Agilack/cowdin-3c-esp-ui/README.md

CowDIN ESP-UI
=============

This project is an electronic module to add a user interface (display +
buttons) as frontend of a DIN enclosure (3U). It can be used for example
with the cowdin ESP32 communication module (see cowdin-3b-esp32)

<table>
<tr>
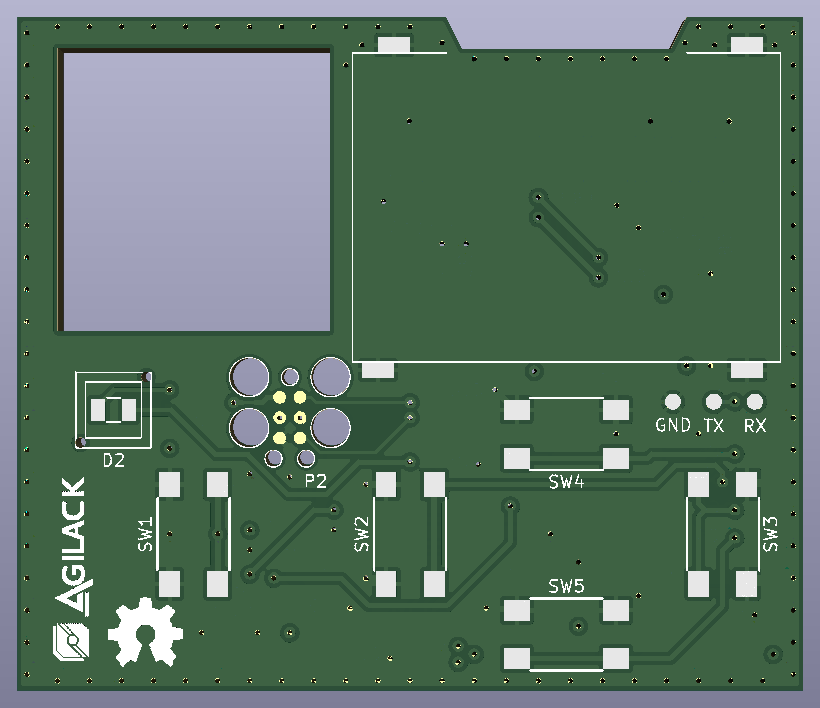
[picture p1: hardware/doc/kicad-3d-top.png]
KiCad 3D (top side)
<td></td>
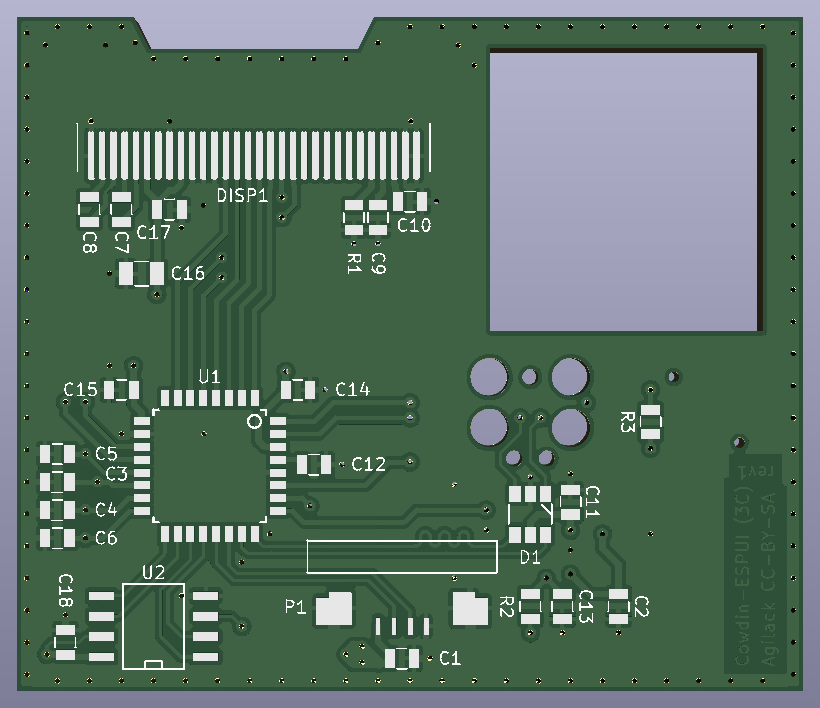
[picture p2: hardware/doc/kicad-3d-bottom.png]
KiCad 3D (bottom side)
<td></td>
</tr><tr>
<td>Fig1: Kicad 3D preview (top)</td>
<td>Fig2: Kicad 3D preview (bottom)</td>
</tr>
</table>

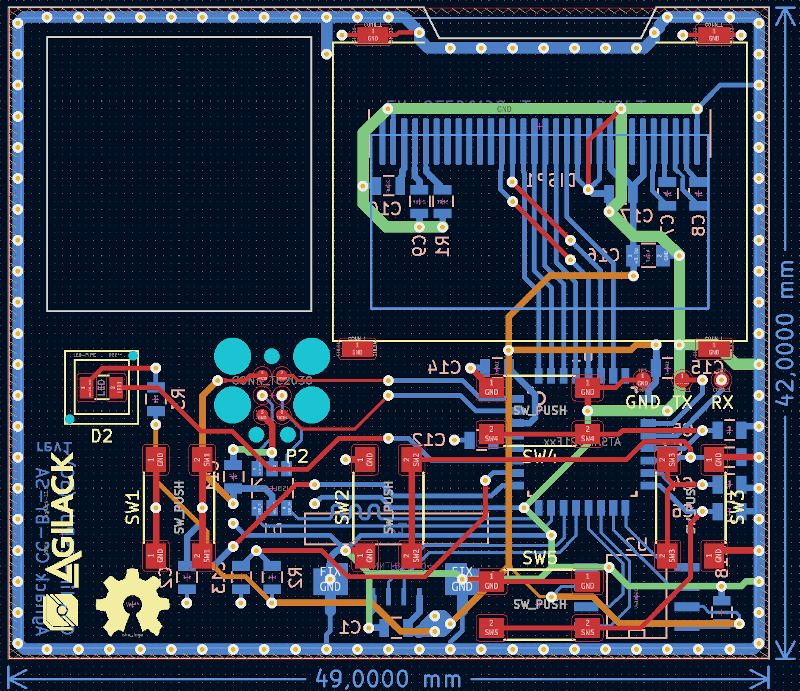
[picture p3: hardware/doc/kicad-routing-preview.png]
Preview of PCB Wip


License
-------

This project is OpenHardware. Hardware design and materials are published
under terms of the Creative Commons ShareAlike license (CC-by-SA) see
hardware/License.md.
