Agilack/cowdin-3c-esp-ui/hardware/prj-kicad/cowdin-3c-esp-ui.kicad_pcb

## KiCad design hardware/prj-kicad/cowdin-3c-esp-ui.kicad_pcb (2022-06-11)

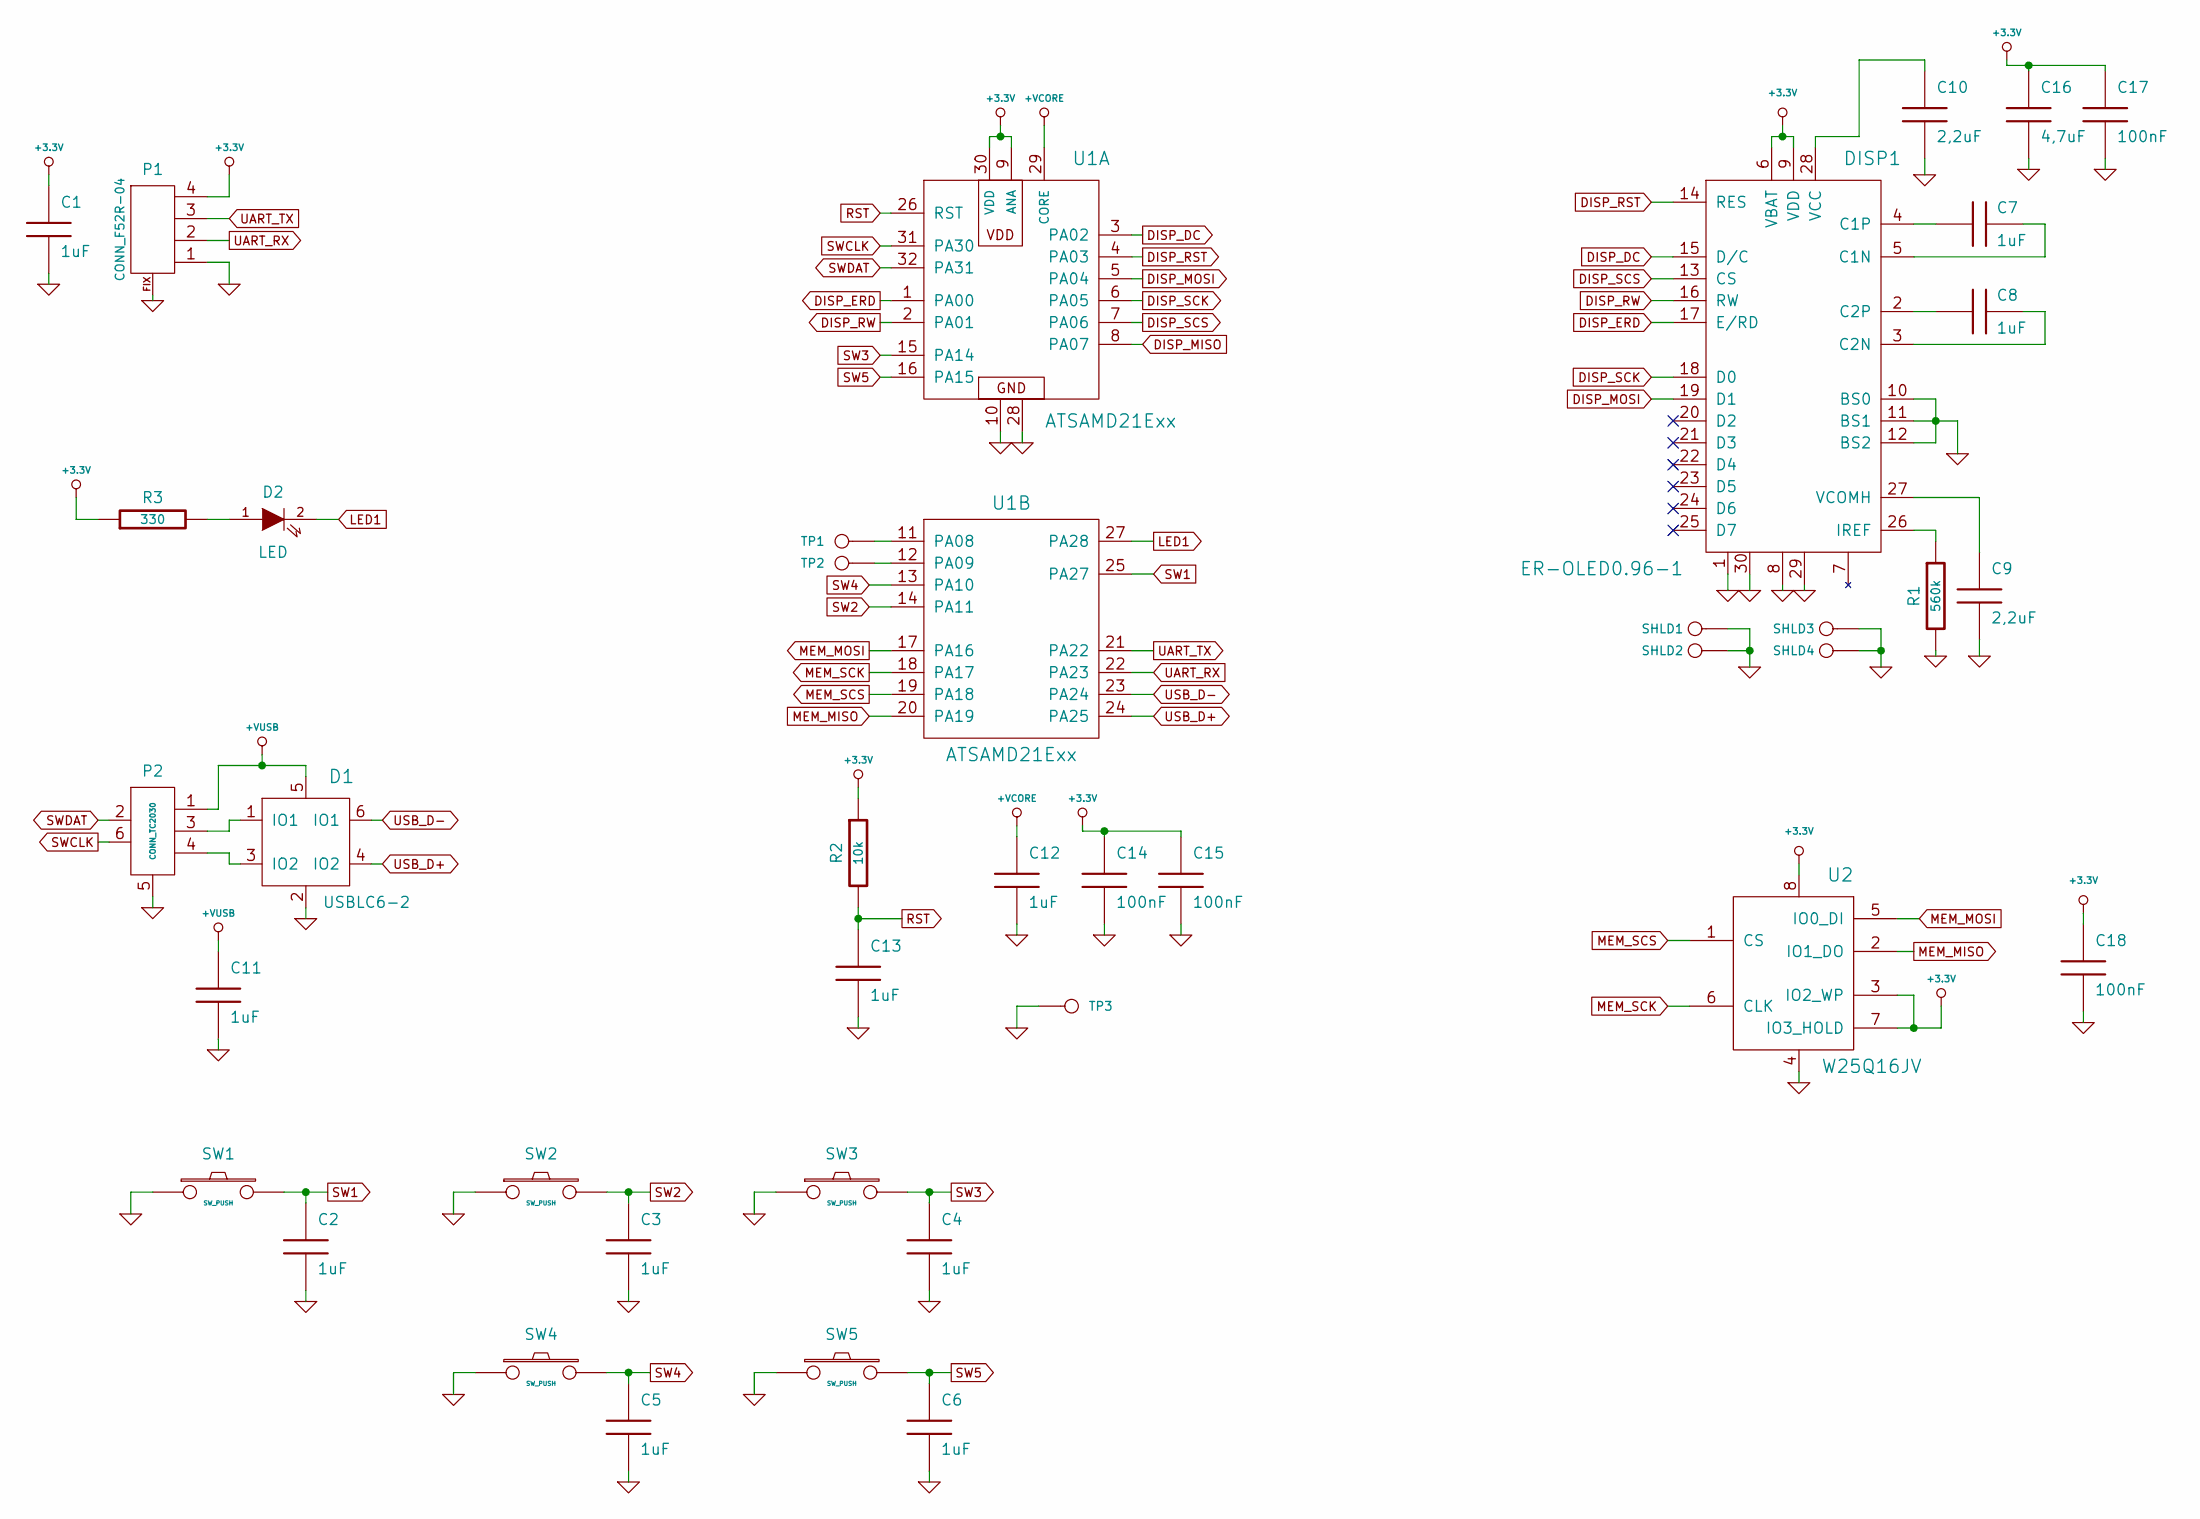
[picture p4: schematic cowdin-3c-esp-ui.kicad_sch, CowDIN button and display module for ESP32 (3B)]

Parts:
C1, C2, C3, C4, C5, C6, C7, C8, C11, C12, C13: 1uF; SMD0603
C9, C10: 2,2uF; SMD0603
C14, C15, C17, C18: 100nF; SMD0603
C16: 4,7uF; SMD0805
D1: USBLC6-2; SOT23-6
D2: LED; SMD0805
DISP1: ER-OLED0.96-1; DISP_EROL30
P1: CONN_F52R-04
P2: CONN_TC2030; TC2030-MCP-FP
R1: 560k; SMD0603
R2: 10k; SMD0603
R3: 330; SMD0603
SHLD1, SHLD2, SHLD3, SHLD4: CONN_1; SHLD_PAD
SW1, SW2, SW3, SW4, SW5: SW_PUSH; SW_TSC015xx
TP1, TP2, TP3: CONN_1; TP_SMD
U1: ATSAMD21Exx; TQFP32
U2: W25Q16JV; SOIC-8

Connections:
+3.3V: C1.1, C14.1, C15.1, C16.1, C17.1, C18.1, DISP1.6 (VBAT), DISP1.9 (VDD), P1.4, R2.1, R3.1, U1.9 (ANA), U1.30 (VDD), U2.3 (IO2_WP), U2.7 (IO3_HOLD), U2.8
+VCORE: C12.1, U1.29 (CORE)
+VUSB: C11.1, D1.5, P2.1 (PWR)
DISP_DC: DISP1.15 (D/C), U1.3 (PA02)
DISP_ERD: DISP1.17 (E/RD), U1.1 (PA00)
DISP_MISO: U1.8 (PA07)
DISP_MOSI: DISP1.19 (D1), U1.5 (PA04)
DISP_RST: DISP1.14 (RES), U1.4 (PA03)
DISP_RW: DISP1.16 (RW), U1.2 (PA01)
DISP_SCK: DISP1.18 (D0), U1.6 (PA05)
DISP_SCS: DISP1.13 (CS), U1.7 (PA06)
LED1: D2.2 (K), U1.27 (PA28)
MEM_MISO: U1.20 (PA19), U2.2 (IO1_DO)
MEM_MOSI: U1.17 (PA16), U2.5 (IO0_DI)
MEM_SCK: U1.18 (PA17), U2.6 (CLK)
MEM_SCS: U1.19 (PA18), U2.1 (CS)
unnamed: C7.1, DISP1.4 (C1P)
unnamed: C7.2, DISP1.5 (C1N)
unnamed: C8.1, DISP1.2 (C2P)
unnamed: C8.2, DISP1.3 (C2N)
unnamed: C9.1, DISP1.27 (VCOMH)
unnamed: C10.1, DISP1.28 (VCC)
unnamed: D1.1 (IO1), P2.3 (USB1)
unnamed: D1.3 (IO2), P2.4 (USB2)
unnamed: D2.1 (A), R3.2
unnamed: DISP1.26 (IREF), R1.1
unnamed: TP1.1, U1.11 (PA08)
unnamed: TP2.1, U1.12 (PA09)
RST: C13.1, R2.2, U1.26 (RST)
SW1: C2.1, SW1.2, U1.25 (PA27)
SW2: C3.1, SW2.2, U1.14 (PA11)
SW3: C4.1, SW3.2, U1.15 (PA14)
SW4: C5.1, SW4.2, U1.13 (PA10)
SW5: C6.1, SW5.2, U1.16 (PA15)
SWCLK: P2.6 (DBG2), U1.31 (PA30)
SWDAT: P2.2 (DBG1), U1.32 (PA31)
UART_RX: P1.2 (PM), U1.22 (PA23)
UART_TX: P1.3, U1.21 (PA22)
USB_D+: D1.4 (IO2), U1.24 (PA25)
USB_D-: D1.6 (IO1), U1.23 (PA24)

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
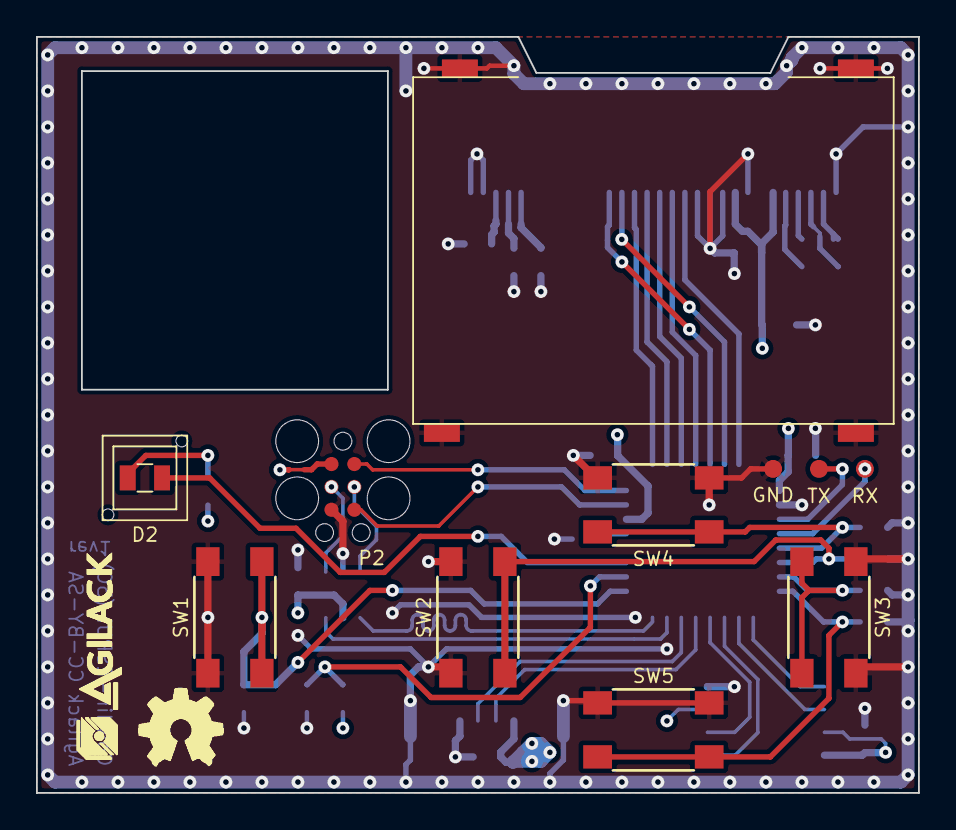
[picture p5: board cowdin-3c-esp-ui.kicad_pcb from above]

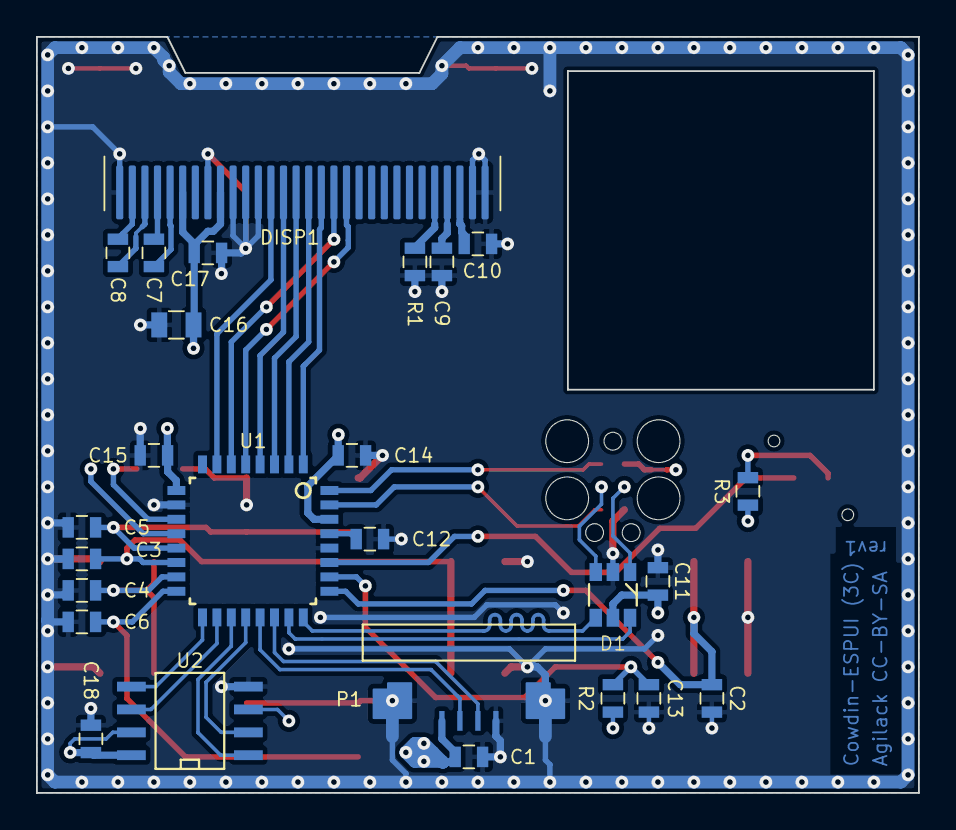
[picture p6: board cowdin-3c-esp-ui.kicad_pcb from below]

Board: 4 copper layers, 49.0 x 42.0 mm, 42 parts (26 on the bottom side), 40 nets.

Other parts of the board:
agilack-11.5: 450px; logo-agilack-11.5
ohw_logo: VAL**; logo-ohw
