Agilack/cowdin-3c-esp-ui/firmware/src/display_font.h

/**
 * @file  display_font.h
 * @brief Bitmap of the default 8x8 text font
 *
 * @author Saint-Genest Gwenael <gwen@cowlab.fr>
 * @copyright Agilack (c) 2022
 *
 * @page License
 * Cowdin-3C-ui firmware is free software: you can redistribute it and/or
 * modify it under the terms of the GNU Lesser General Public License
 * version 3 as published by the Free Software Foundation. You should
 * have received a copy of the GNU Lesser General Public License along
 * with this program, see LICENSE.md file for more details.
 * This program is distributed WITHOUT ANY WARRANTY.
 */
#ifndef FONT_H
#define FONT_H

const unsigned char font[96][8] = {
/* 0x20 */
    { 0x00, 0x00, 0x00, 0x00, 0x00, 0x00, 0x00, 0x00 }, /* space */
    { 0x00, 0x00, 0x00, 0x00, 0x2F, 0x00, 0x00, 0x00 }, /* ! */
    { 0x00, 0x00, 0x03, 0x00, 0x03, 0x00, 0x00, 0x00 }, /* " */
    { 0x00, 0x14, 0x3E, 0x14, 0x3E, 0x14, 0x00, 0x00 }, /* # */
    { 0x00, 0x00, 0x24, 0x2A, 0x7F, 0x2A, 0x12, 0x00 }, /* $ */
    { 0x02, 0x05, 0x15, 0x0A, 0x14, 0x2A, 0x28, 0x10 }, /* % */
    { 0x00, 0x00, 0x16, 0x29, 0x29, 0x11, 0x10, 0x28 }, /* & */
    { 0x00, 0x00, 0x00, 0x00, 0x03, 0x00, 0x00, 0x00 }, /* ' */
    { 0x00, 0x00, 0x0C, 0x12, 0x21, 0x00, 0x00, 0x00 }, /* ( */
    { 0x00, 0x00, 0x00, 0x21, 0x12, 0x0C, 0x00, 0x00 }, /* ) */
    { 0x00, 0x00, 0x15, 0x0E, 0x1F, 0x0E, 0x15, 0x00 }, /* * */
    { 0x00, 0x00, 0x08, 0x08, 0x3E, 0x08, 0x08, 0x00 }, /* + */
    { 0x00, 0x00, 0x00, 0x40, 0x20, 0x00, 0x00, 0x00 }, /* , */
    { 0x00, 0x00, 0x08, 0x08, 0x08, 0x08, 0x00, 0x00 }, /* - */
    { 0x00, 0x00, 0x00, 0x00, 0x20, 0x00, 0x00, 0x00 }, /* . */
    { 0x00, 0x20, 0x10, 0x08, 0x04, 0x02, 0x01, 0x00 }, /* / */
/* 0x30 */
    { 0x00, 0x0C, 0x12, 0x21, 0x21, 0x12, 0x0C, 0x00 }, /* 0 */
    { 0x00, 0x00, 0x00, 0x22, 0x3F, 0x20, 0x00, 0x00 }, /* 1 */
    { 0x00, 0x22, 0x31, 0x29, 0x29, 0x25, 0x22, 0x00 }, /* 2 */
    { 0x00, 0x12, 0x21, 0x29, 0x29, 0x25, 0x12, 0x00 }, /* 3 */
    { 0x00, 0x18, 0x14, 0x12, 0x3F, 0x10, 0x00, 0x00 }, /* 4 */
    { 0x00, 0x17, 0x25, 0x25, 0x25, 0x25, 0x19, 0x00 }, /* 5 */
    { 0x00, 0x1E, 0x25, 0x25, 0x25, 0x25, 0x18, 0x00 }, /* 6 */
    { 0x00, 0x21, 0x11, 0x09, 0x05, 0x03, 0x01, 0x00 }, /* 7 */
    { 0x00, 0x1A, 0x25, 0x25, 0x25, 0x25, 0x1A, 0x00 }, /* 8 */
    { 0x00, 0x06, 0x29, 0x29, 0x29, 0x29, 0x1E, 0x00 }, /* 9 */
    { 0x00, 0x00, 0x00, 0x00, 0x24, 0x00, 0x00, 0x00 }, /* : */
    { 0x00, 0x00, 0x00, 0x40, 0x24, 0x00, 0x00, 0x00 }, /* ; */
    { 0x00, 0x08, 0x08, 0x14, 0x14, 0x22, 0x22, 0x00 }, /* < */
    { 0x00, 0x14, 0x14, 0x14, 0x14, 0x14, 0x14, 0x00 }, /* = */
    { 0x00, 0x22, 0x22, 0x14, 0x14, 0x08, 0x08, 0x00 }, /* > */
    { 0x00, 0x02, 0x01, 0x29, 0x09, 0x06, 0x00, 0x00 }, /* ? */
/* 0x40 */
    { 0x18, 0x24, 0x42, 0xBA, 0xAA, 0xBE, 0x00, 0x00 }, /* @ */
    { 0x00, 0x30, 0x0C, 0x0B, 0x0B, 0x0C, 0x30, 0x00 }, /* A */
    { 0x00, 0x3F, 0x25, 0x25, 0x25, 0x1A, 0x00, 0x00 }, /* B */
    { 0x0C, 0x12, 0x21, 0x21, 0x21, 0x12, 0x00, 0x00 }, /* C */
    { 0x00, 0x3F, 0x21, 0x21, 0x21, 0x1E, 0x00, 0x00 }, /* D */
    { 0x00, 0x3F, 0x25, 0x25, 0x25, 0x21, 0x00, 0x00 }, /* E */
    { 0x00, 0x3F, 0x05, 0x05, 0x05, 0x01, 0x00, 0x00 }, /* F */
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
};
#endif
/* EOF */
