Agilack/cowdin-3c-esp-ui/(commit log)

2022-06-10 Hardware: Create pcb skeleton, add display and buttons
    [cowdin-3c-esp-ui.kicad_pcb, cowdin-3c-esp-ui.kicad_sch]
2022-06-11 Hardware: Add MCU and main components. Create productions files for rev1
    [cowdin-3c-esp-ui-B_Cu.gbr, cowdin-3c-esp-ui-B_Mask.gbr, cowdin-3c-esp-ui-B_Paste.gbr, cowdin-3c-esp-ui-B_Silkscreen.gbr, cowdin-3c-esp-ui-Edge_Cuts.gbr, cowdin-3c-esp-ui-F_Cu.gbr, cowdin-3c-esp-ui-F_Mask.gbr, cowdin-3c-esp-ui-F_Paste.gbr]
2022-06-17 Firmware: Create basic firmware (configure IOs, control LED and UART)
    [gdb.cfg]
2022-06-18 Firmware: Add driver for OLED display (spi) and remap uart to avoid conflict
    [display.c, display.h, display_font.h, hardware.c, main.c, uart.c]
