Agilack/cowdin-3c-esp-ui/(notices)

Notices in the files:
hardware/prj-kicad/cowdin-3c-esp-ui.kicad_pcb:
Agilack CC-BY-SA
